lawabb/PowerWindows/Schematic_Power Windows PCB_2020-05-10_15-38-11.pdf

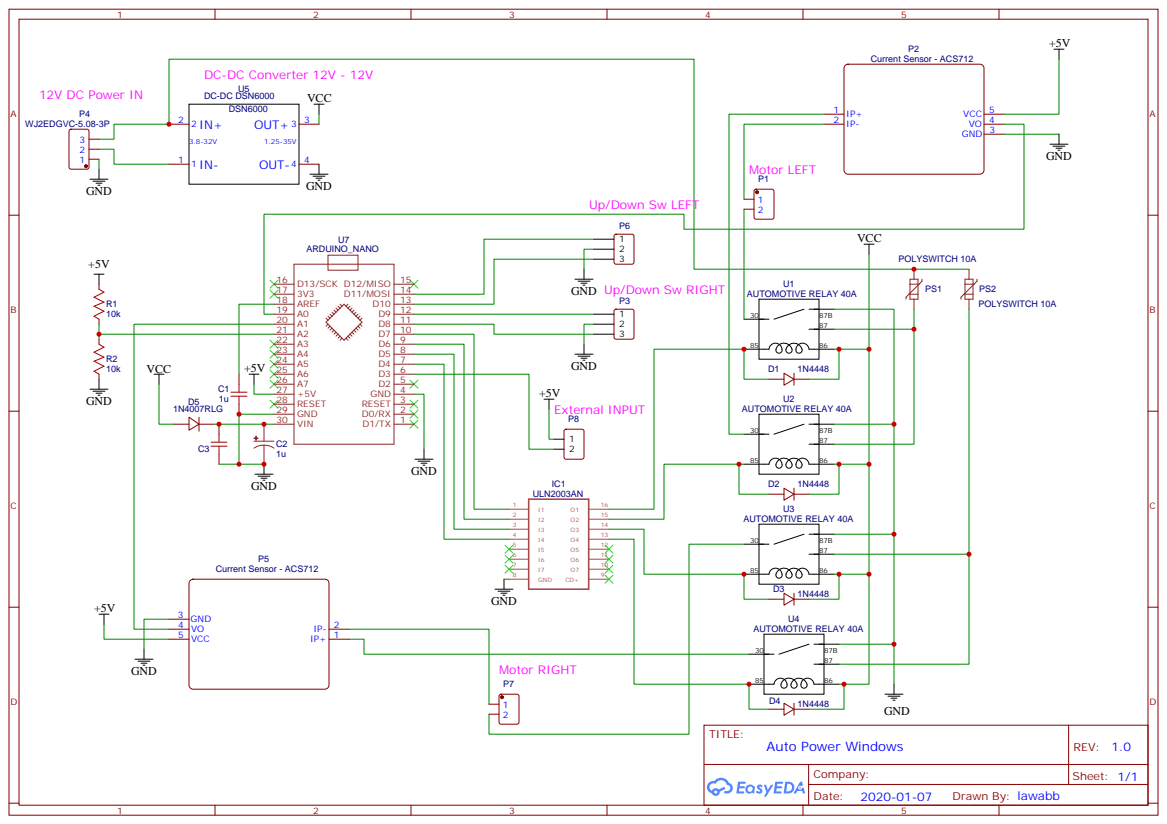
[picture p2: page 1]

Up/Down Sw RIGHT
GND
