lawabb/PowerWindows/Schematic_Power Windows_Sheet_1_20191224233008.pdf

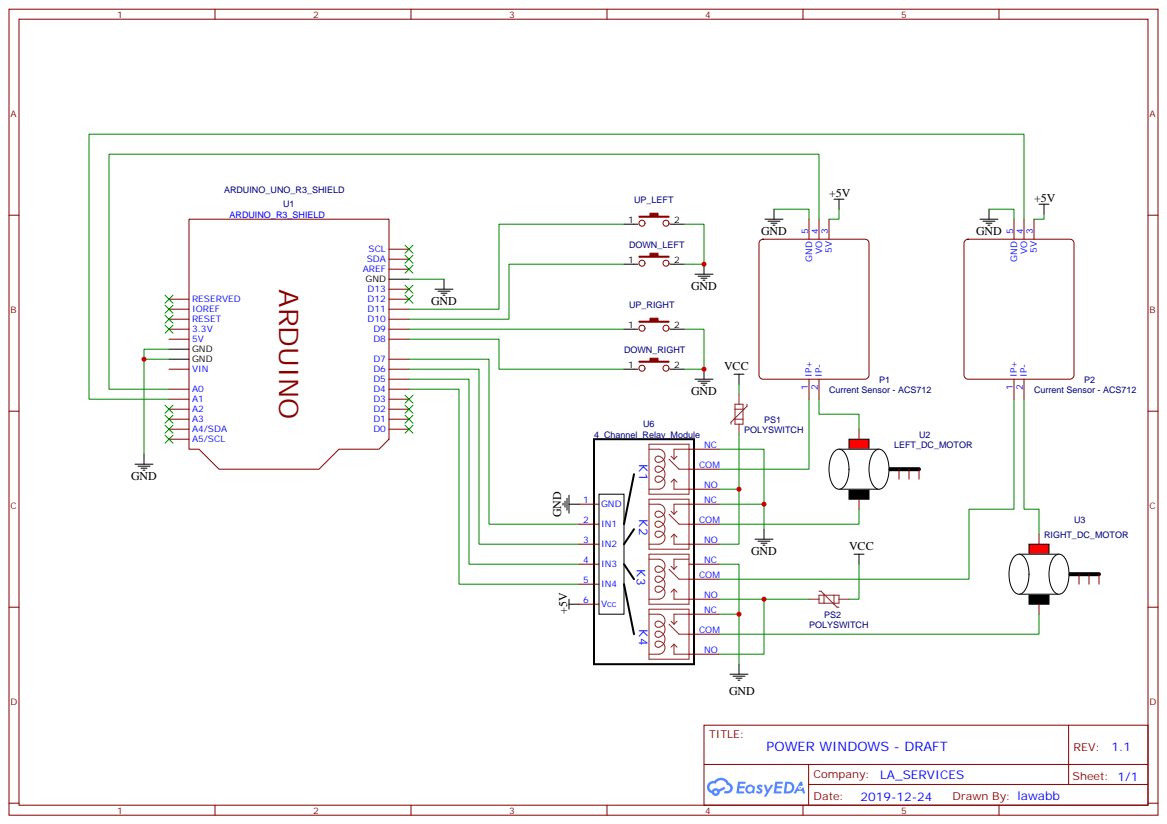
[picture p3: page 1]
