lawabb/PowerWindows/PowerWindows.ino

#include <Arduino_BuiltIn.h>

/*****************************************
 *  Power Windows
 *  (c) Lawrie Abbott 2026
 *  
 *  Tested with Arduino Nano
 *  Note: Set variables in PW.h
 *  
 *   _L is for left _R is for right
 *****************************************/

#include "PW.h"
#include "utility.h"

#define RelayA_L 7
#define RelayB_L 6
#define RelayA_R 5 
#define RelayB_R 4
//
#define SwitchUp_L 11
#define SwitchDn_L 10
#define SwitchUp_R 9
#define SwitchDn_R 8
#define CurrentSens_L A0
#define CurrentSens_R A1
#define AZero A2

bool left = 1;

// Create Left and Right hand instances of PW (Power Windows) main functions
PW* PW_L = new PW();
PW* PW_R = new PW();

void setup()
{
  Serial.begin(115200);

  // Relay Outputs
  pinMode(RelayA_L, OUTPUT);
  pinMode(RelayB_L, OUTPUT);
  pinMode(RelayA_R, OUTPUT);
  pinMode(RelayB_R, OUTPUT);

  // Set to default/off
  digitalWrite(RelayA_L, AT_REST);
  digitalWrite(RelayB_L, AT_REST);
  digitalWrite(RelayA_R, AT_REST);
  digitalWrite(RelayB_R, AT_REST);
  
  // Control Switches
  pinMode(SwitchUp_L, INPUT_PULLUP);
  pinMode(SwitchDn_L, INPUT_PULLUP);
  pinMode(SwitchUp_R, INPUT_PULLUP);
  pinMode(SwitchDn_R, INPUT_PULLUP);

  // Analogue Current Sense
  pinMode(CurrentSens_L, INPUT);
  pinMode(CurrentSens_R, INPUT);

  // Create Left and Right hand instances of PW (Power Windows) main functions
  PW_L->Init(RelayA_L, RelayB_L, SwitchUp_L, SwitchDn_L, CurrentSens_L, left);
  PW_R->Init(RelayA_R, RelayB_R, SwitchUp_R, SwitchDn_R, CurrentSens_R, !left);
  
  Serial.print("Version: ");
  Serial.println(SoftwareVersion);
}  

void loop()
{
  PW_L-> SwitchStateUp();
  PW_L-> SwitchStateDn();
  PW_L->Up();
  PW_L->Down();
  PW_L->Timeout();
  PW_L->Sensor(CurrentSens_L, ACS_L);

  if (PW_L->abort_wind) {
    Serial.println("Aborting Winding L");
    PW_L->WindowStop();
    delay(2000);
    }

  PW_R-> SwitchStateUp();
  PW_R-> SwitchStateDn();
  PW_R->Up();
  PW_R->Down();
  PW_R->Timeout();
  PW_R->Sensor(CurrentSens_R, ACS_R);
  
  if (PW_R->abort_wind) {
    Serial.println("Aborting Winding R"); 
    PW_R->WindowStop();
    // if button stuck after timeout
    delay(2000);
    }  
} 
