lawabb/PowerWindows/(commit log)

2019-12-18 Add sample schematic
2019-12-26 Current sense code added
2019-12-31 SENSOR changes
2020-02-22 Testing ACS712 current sensor
